M-Rollins/automated_chess_board/arduino_programming_info.txt

	As of 2025/08/16, works with:
Arduino IDE 1.8.16
Board: "Arduino Nano"
Processor: "ATmega328P (Old Bootloader)"
Programmer: "AVR ISP"

Driver (Ports>USB-Serial CH340): version 3.4.2014.8

2025/10/03: version 3.3.2011.11
https://sparks.gogo.co.nz/ch340.html
official site: https://www.wch-ic.com/downloads/ch341ser_zip.html
