M-Rollins/automated_chess_board/(list of files, cad)

Other CAD files:
hardware/rotary_switch_dimensions.SLDPRT
hardware/rotary_switch_dimensions.DXF
