M-Rollins/automated_chess_board/hardware/IO_board/IO_board.kicad_pcb

## KiCad design hardware/IO_board/IO_board.kicad_pcb (2025-12-19)

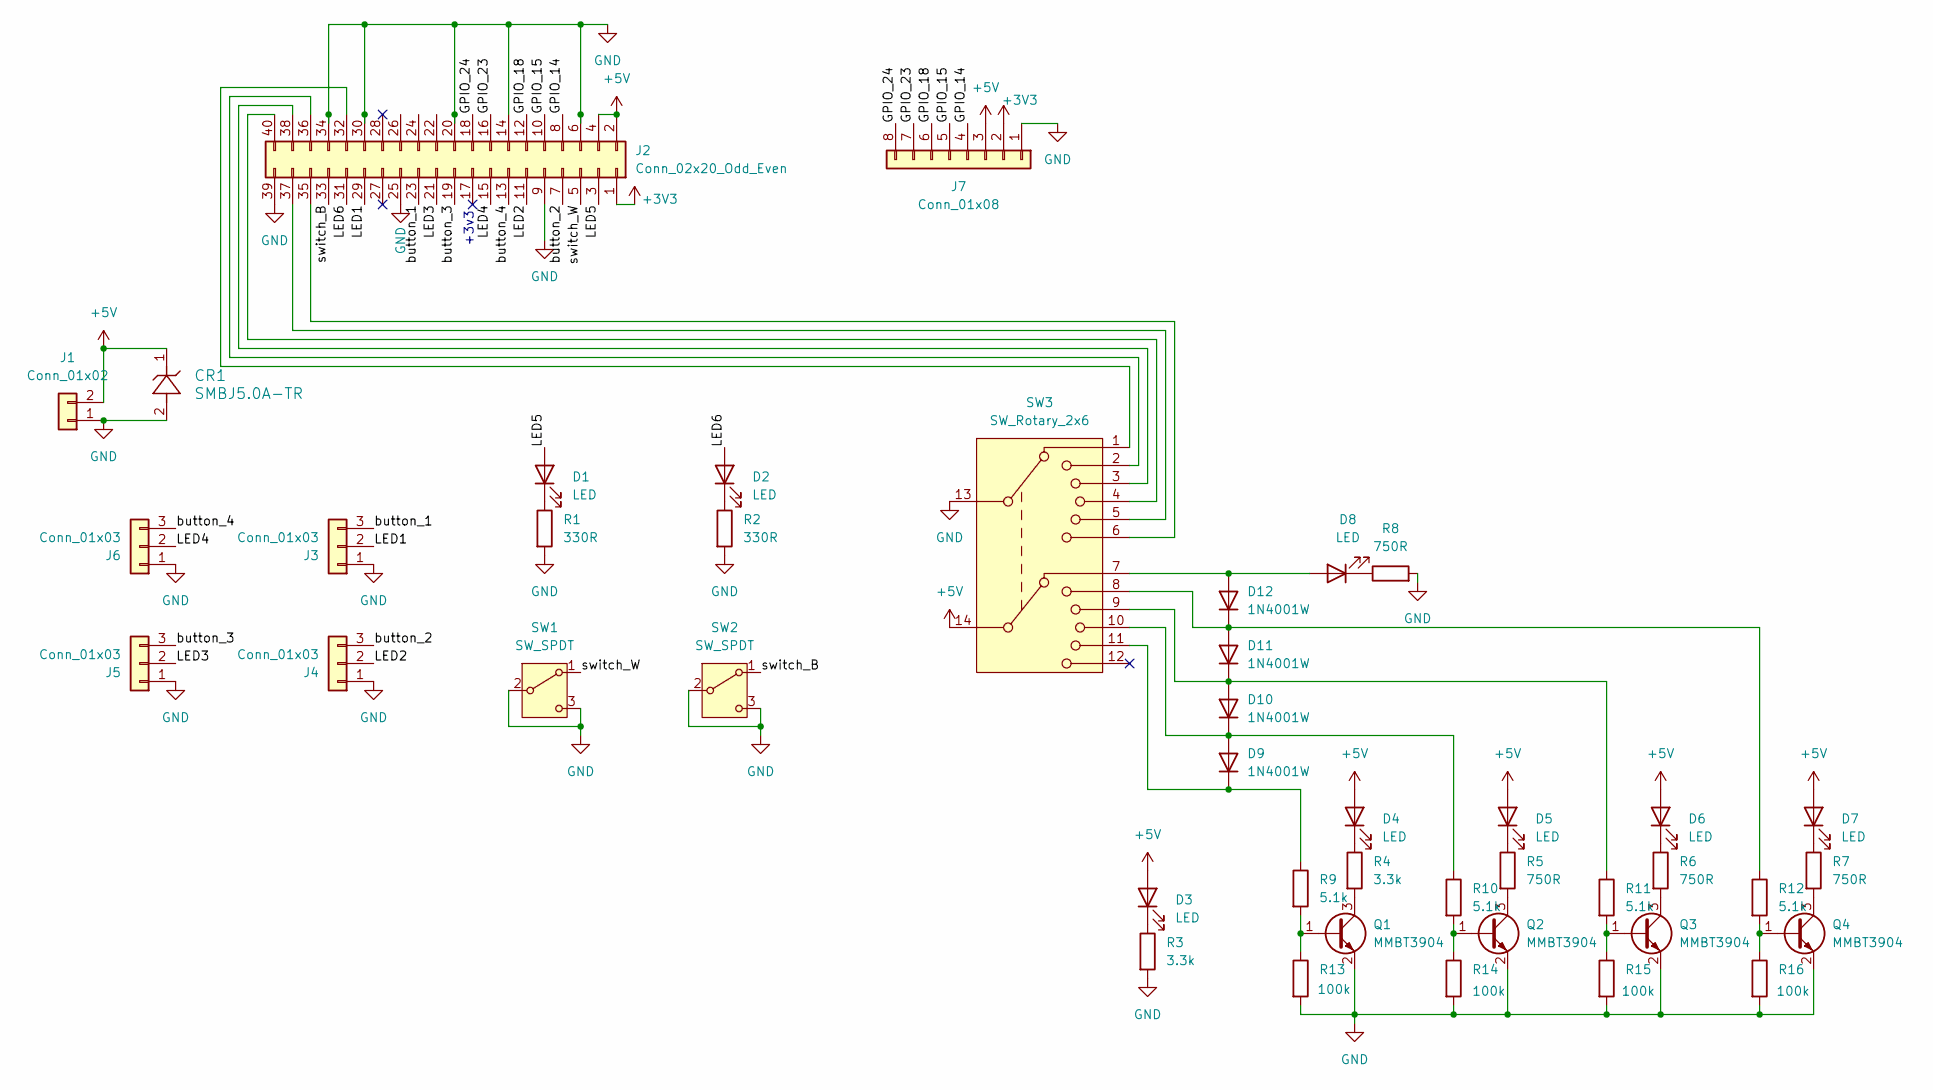
[picture p1: schematic IO_board.kicad_sch]

Parts:
CR1: SMBJ5.0A-TR; SMB_STM
D1, D2: LED; LED_D5.0mm
D3, D4, D5, D6, D7, D8: LED; LED_0805_2012Metric_Pad1.15x1.40mm_HandSolder
D9, D10, D11, D12: 1N4001W; D_SOD-123F
J1: Conn_01x02; JST_EH_B2B-EH-A_1x02_P2.50mm_Vertical
J2: Conn_02x20_Odd_Even; PinHeader_2x20_P2.54mm_Vertical_MIRROR
J3, J4, J5, J6: Conn_01x03; JST_EH_B3B-EH-A_1x03_P2.50mm_Vertical
J7: Conn_01x08; PinHeader_1x08_P2.54mm_Vertical
Q1, Q2, Q3, Q4: MMBT3904; SOT-23
R1, R2: 330R; R_0805_2012Metric_Pad1.20x1.40mm_HandSolder
R3, R4: 3.3k; R_0805_2012Metric_Pad1.20x1.40mm_HandSolder
R5, R6, R7, R8: 750R; R_0805_2012Metric_Pad1.20x1.40mm_HandSolder
R9, R10, R11, R12: 5.1k; R_0805_2012Metric_Pad1.20x1.40mm_HandSolder
R13, R14, R15, R16: 100k; R_0805_2012Metric_Pad1.20x1.40mm_HandSolder
SW1, SW2: SW_SPDT; SW_toggle
SW3: SW_Rotary_2x6; SW_rotary_2x6

Connections:
+3V3: J2.1, J7.2
+5V: CR1.1, D3.2 (A), D4.2 (A), D5.2 (A), D6.2 (A), D7.2 (A), J1.2, J2.2, J2.4, J7.3, SW3.14
/GPIO_14: J2.8, J7.4
/GPIO_15: J2.10, J7.5
/GPIO_18: J2.12, J7.6
/GPIO_23: J2.16, J7.7
/GPIO_24: J2.18, J7.8
/LED1: J2.29, J3.2
/LED2: J2.11, J4.2
/LED3: J2.21, J5.2
/LED4: J2.15, J6.2
/LED5: D1.2 (A), J2.3
/LED6: D2.2 (A), J2.31
/button_1: J2.23, J3.3
/button_2: J2.7, J4.3
/button_3: J2.19, J5.3
/button_4: J2.13, J6.3
/switch_B: J2.33, SW2.1 (A)
/switch_W: J2.5, SW1.1 (A)
GND: CR1.2, J1.1, J2.6, J2.9, J2.14, J2.20, J2.25, J2.30, J2.34, J2.39, J3.1, J4.1, J5.1, J6.1, J7.1, Q1.2 (E), Q2.2 (E), Q3.2 (E), Q4.2 (E), R1.2, R2.2, R3.2, R8.2, R13.2, R14.2, R15.2, R16.2, SW1.2 (B), SW1.3 (C), SW2.2 (B), SW2.3 (C), SW3.13
unnamed: D1.1 (K), R1.1
unnamed: D2.1 (K), R2.1
unnamed: D3.1 (K), R3.1
unnamed: D4.1 (K), R4.1
unnamed: D5.1 (K), R5.1
unnamed: D6.1 (K), R6.1
unnamed: D7.1 (K), R7.1
unnamed: D8.1 (K), R8.1
unnamed: D9.1 (K), R9.1, SW3.11
unnamed: D10.2 (A), D11.1 (K), R11.1, SW3.9
unnamed: D9.2 (A), D10.1 (K), R10.1, SW3.10
unnamed: D11.2 (A), D12.1 (K), R12.1, SW3.8
unnamed: D8.2 (A), D12.2 (A), SW3.7
unnamed: J2.32, SW3.1
unnamed: J2.35, SW3.6
unnamed: J2.36, SW3.2
unnamed: J2.37, SW3.5
unnamed: J2.38, SW3.3
unnamed: J2.40, SW3.4
unnamed: Q1.1 (B), R9.2, R13.1
unnamed: Q1.3 (C), R4.2
unnamed: Q2.1 (B), R10.2, R14.1
unnamed: Q2.3 (C), R5.2
unnamed: Q3.1 (B), R11.2, R15.1
unnamed: Q3.3 (C), R6.2
unnamed: Q4.1 (B), R12.2, R16.1
unnamed: Q4.3 (C), R7.2

Notes on the sheet:
+3v3

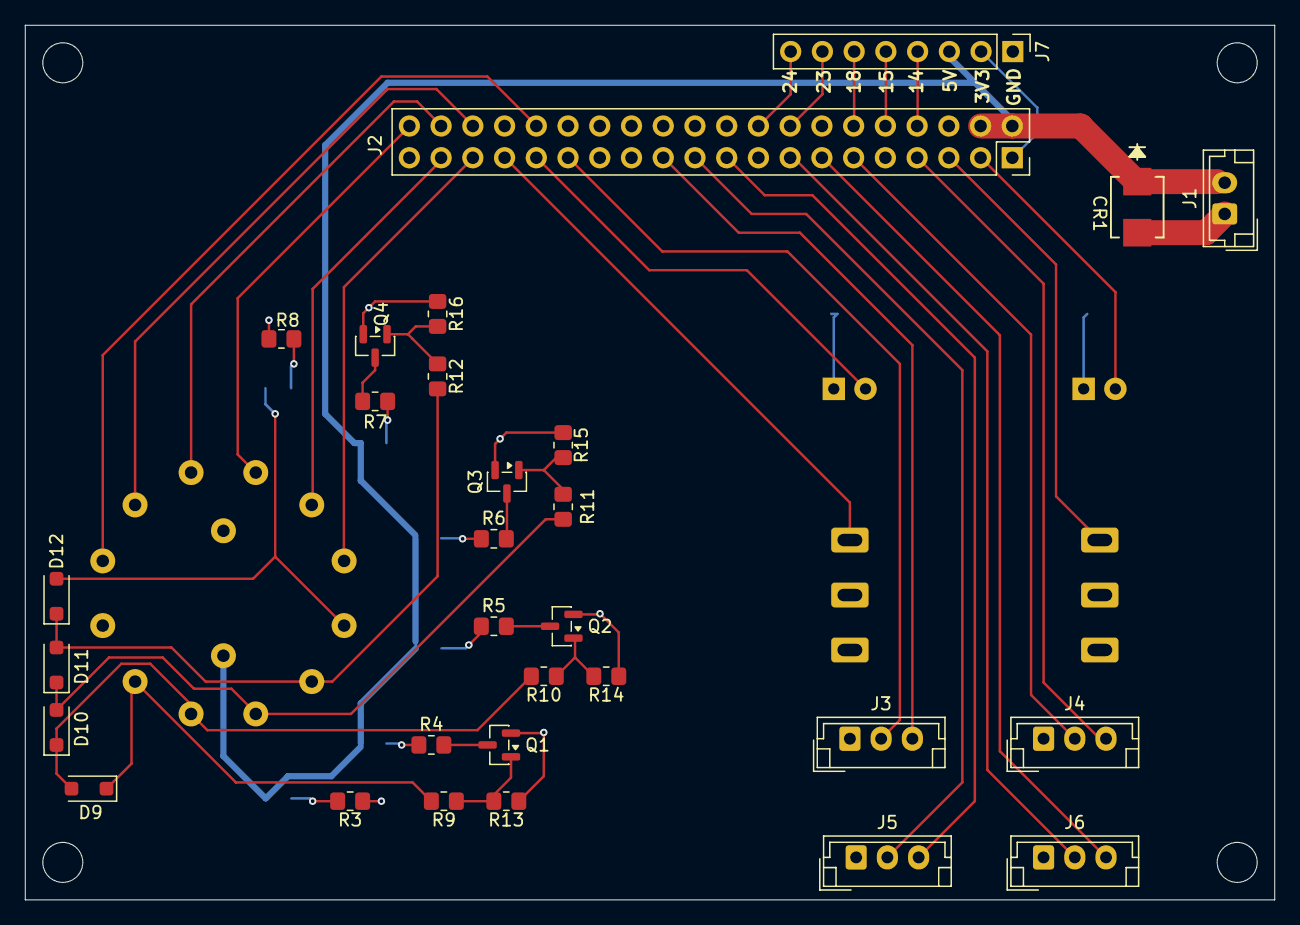
[picture p2: board IO_board.kicad_pcb from above]

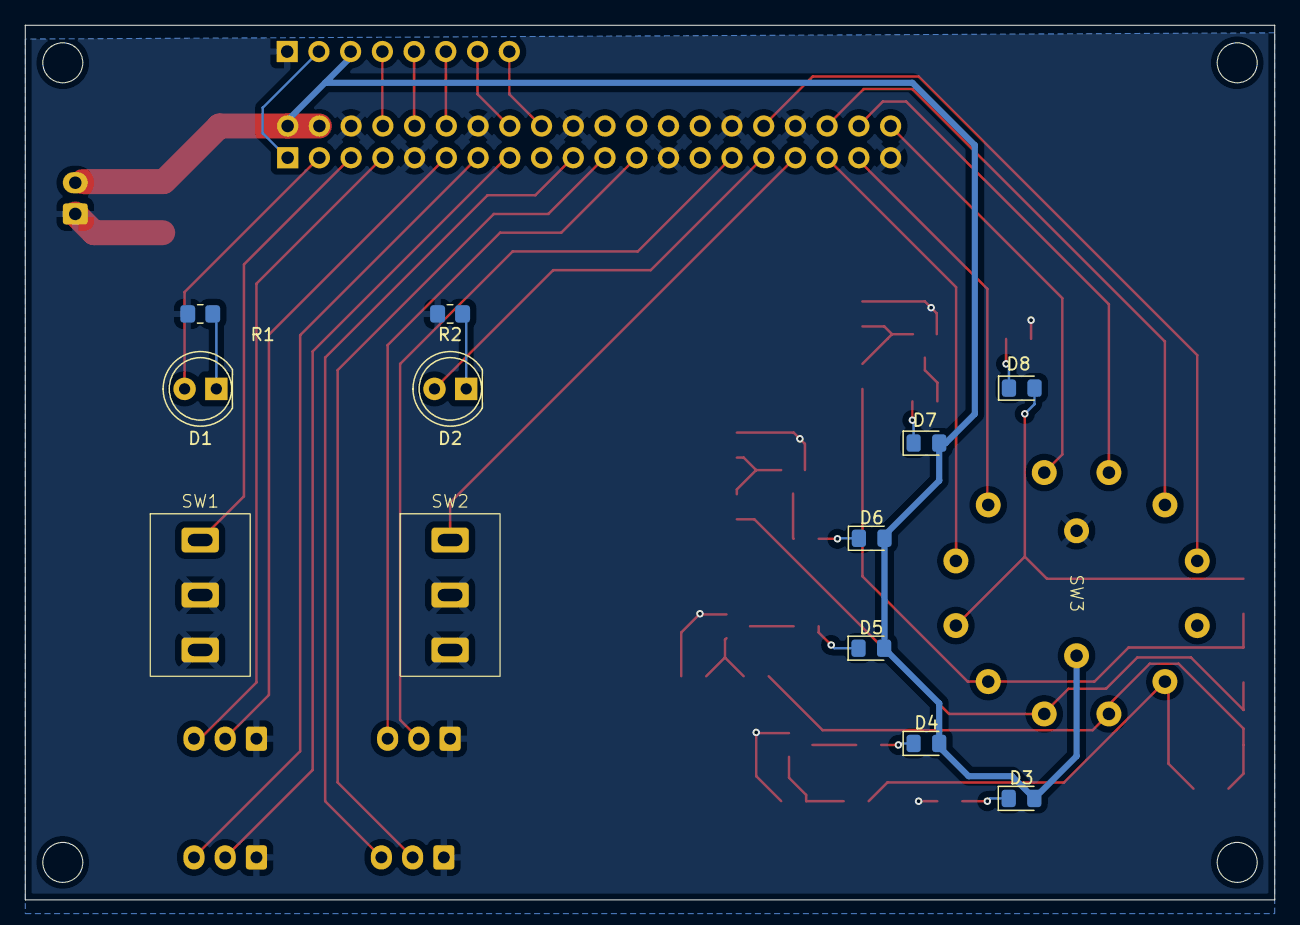
[picture p3: board IO_board.kicad_pcb from below]

Board: 2 copper layers, 100.0 x 70.0 mm, 43 parts (13 on the bottom side), 47 nets.
