M-Rollins/automated_chess_board/arduino/BoardControl/MotorControl.cpp

/*
 * motor_control.cpp - classes for cnc control of stepper-driven motion axes
 */
#include "Arduino.h"
#include "MotorControl.h"

const int StepperMotor::PULSE_WIDTH_MICROSECONDS = 5;
const float Axis::V_MIN = 50; // full steps per second (1 step = 0.2mm)
const float Axis::V_MAX = 600;
const float Axis::HOME_SPEED = 400;
const float Axis::ACCEL = 1000; //full steps/s^2

const int Axis::GO_TO_TARGET = 0;
const int Axis::RAMP_CYCLE = 1;
const int Axis::SPLINE = 2;

//=======================================================
StepperMotor::StepperMotor(){}
StepperMotor::StepperMotor(int s, int d, int msPin1, int msPin2, boolean f){
  stepPin = s;
  dirPin = d;
  ms1 = msPin1;
  ms2 = msPin2;
  pinMode(stepPin, OUTPUT);
  pinMode(dirPin, OUTPUT);
  pinMode(ms1, OUTPUT);
  pinMode(ms2, OUTPUT);
  setMicrostepping(1);
  
  forward = f;
  digitalWrite(stepPin, LOW);
  digitalWrite(dirPin, forward);
}

boolean StepperMotor::setMicrostepping(int steps){
  switch(steps){
    case 1:
      digitalWrite(ms1, LOW);
      digitalWrite(ms2, LOW);
      return true;
    case 2:
      digitalWrite(ms1, HIGH);
      digitalWrite(ms2, LOW);
      return true;
    case 4:
      digitalWrite(ms1, LOW);
      digitalWrite(ms2, HIGH);
      return true;
    case 8:
      digitalWrite(ms1, HIGH);
      digitalWrite(ms2, HIGH);
      return true;
    default:
      Serial.println("Invalid microstep resolution. Only values of 1, 2, 4, and 8 are valid.");
      return false;    
  }
}

void StepperMotor::step(boolean d){
  digitalWrite(dirPin, d == forward);
  digitalWrite(stepPin, HIGH);
  delayMicroseconds(PULSE_WIDTH_MICROSECONDS);
  digitalWrite(stepPin, LOW);
  delayMicroseconds(PULSE_WIDTH_MICROSECONDS);
}

//=======================================================
Axis::Axis(){}
Axis::Axis(StepperMotor m, int lp, int switchPin){
  motor = m;
  limitPos = lp;
  safetyLimit = limitPos + 1000;
  limSwitch = switchPin;
  pos = 0;
  target = 0;
  v = 0;
  speedFactor = 1;
  isHomed = false;
  mode = GO_TO_TARGET;
  pinMode(limSwitch, INPUT_PULLUP);
  setMicrostepping(1);
}

void Axis::setMicrostepping(int steps){
  if(motor.setMicrostepping(steps)){
    microstepping = steps;
  }else{
    Serial.println("error setting microstepping resolution");
  }
}

//pass a number between 0 and 1 to slow down the axis
void Axis::setSpeedFactor(float s){
  speedFactor = s;
}

void Axis::setTarget(int t){
  target = t;
  mode = GO_TO_TARGET;
}

void Axis::followRampCycle(float currentSpeed, float accel, float coastStartTime, float coastStopTime, float cycleStopTime){
  mode = RAMP_CYCLE;
  x0 = pos;
  v0 = currentSpeed;
  a0 = accel;
  lastTime = micros();
  t1 = coastStartTime;
  t2 = coastStopTime;
  tf = cycleStopTime;
}

void Axis::followSpline(float a, float b, float c, float stopTime){
  mode = SPLINE;
  x0 = pos;
  v0 = c;
  a0 = b;
  jerk = a;
  lastTime = micros();
  tf = stopTime;
}

boolean Axis::atTarget(){
  return mode == GO_TO_TARGET && pos == target;
}

int Axis::getPos(){
  return pos;
}

boolean Axis::homeAxis(){
  float lastTime = micros();
  stepDelay = 1000000 / (HOME_SPEED * microstepping);

  //move the axis until reaching the limit switch
  while(!digitalRead(limSwitch)){
    unsigned long t = micros();
    if(t - lastTime > stepDelay){
      //update the time, but avoid sending many steps in quick succession if there is a delay
      while(t - lastTime >= stepDelay) {lastTime += stepDelay;};
      motor.step(true);
      pos += 1./microstepping;

      //stop the program if the limit switch is not detected
      if(pos >= safetyLimit){
        isHomed = false;
        return false;
      }
    }
  }
  //recognize the home position
  pos = limitPos;
  target = pos;
  isHomed = true;
  return true;
}


void Axis::updateAxis(){
  //don't move without knowing where the axis is
  if(!isHomed){
    return;
  }

  switch(mode){
    case GO_TO_TARGET:
      updateGoToTarget();
      break;
    case RAMP_CYCLE:
      updateRampCycle();
      break;
    case SPLINE:
      updateSpline();
      break;
  }
}

void Axis::updateGoToTarget(){
  if(pos == target){
    return;
  }
  
  if(v == 0){
    // when the motor is stopped and gets a new target position, start moving
    v = V_MIN * speedFactor;
    rampUp = true;
    lastTime = micros();
    return;
  }
  
  //move the motor
  stepDelay = 1000000 / (v * microstepping);

  //TODO: overflow protection? (rolls over every ~1hr)
  unsigned long t = micros();
  if(t - lastTime >= stepDelay){
    //update the time, but avoid sending many steps in quick succession if there is a delay
    while(t - lastTime >= stepDelay) {lastTime += stepDelay;};
    if(pos < target){
      motor.step(true);
      pos += 1./microstepping;
    }else if (pos > target){
      motor.step(false);
      pos -= 1./microstepping;
    }
    //check the limit swicth after each step
    if(digitalRead(limSwitch)){
      pos = limitPos;
    }
    
    //accelerate up to max speed
    if(rampUp){
      v += ACCEL * speedFactor * stepDelay/1000000.;
      if(v >= V_MAX * speedFactor) {
        v = V_MAX * speedFactor;
        rampUp = false;
      }
    }
    // decelerate down to minimum speed as the destination approaches
    float stoppingDist = 1. / (2*ACCEL * speedFactor) * (v*v - V_MIN*V_MIN*speedFactor*speedFactor);
    if(abs(pos - target) <= stoppingDist){
      v = max(float(v - ACCEL * speedFactor * stepDelay/1000000.), V_MIN * speedFactor);
      rampUp = false;
    }
  }

  // stop moving when the target is reached
  if(pos == target){
    v = 0;
  }
}

void Axis::updateRampCycle(){
  float t = (micros() - lastTime) / 1000000.;
  float x;
  if(t <= t1){
    x = x0 + v0*t + 0.5*a0*t*t;
  }else if(t <= t2){
    x = x0 + (v0*t1 + 0.5*a0*t1*t1) + (v0 + t1*a0) * (t - t1);
  }else if(t <= tf){
    x = x0 + (v0*t1 + 0.5*a0*t1*t1) + (v0 + t1*a0) * (t - t1) +  - 0.5*a0*(t - t2)*(t - t2);
  }else{
    //end of cycle
    mode = GO_TO_TARGET;
    target = pos;
    return;
  }

  if(x - pos > 0.5/microstepping){
    motor.step(true);
    pos += 1./microstepping;
  }else if(x - pos < -0.5/microstepping){
    motor.step(false);
    pos -= 1./microstepping;
  }
}

void Axis::updateSpline(){
  float t = (micros() - lastTime) / 1000000.;
  if(t <= tf){
    float x = jerk*t*t*t + a0*t*t + v0*t + x0;
    if(x - pos > 0.5/microstepping){
      motor.step(true);
      pos += 1./microstepping;
    }else if(x - pos < -0.5/microstepping){
      motor.step(false);
      pos -= 1./microstepping;
    }
  }else{
    //end of cycle
    mode = GO_TO_TARGET;
    target = pos;
    return;
  }
}
