M-Rollins/automated_chess_board/(commit log)

2025-01-19 adjustded board dimensions
2025-06-28 added reference for board commands
2025-06-29 Broke motion control into separate library
    MotorControl library contains StepperMotor class plus new Axis class which stores current and target position for one motor and controls motion
    [BoardControl.ino, MotorControl.cpp, MotorControl.h]
2025-08-18 command handling and board tracking updates
    - Modified command parsing
    - began implementing board state tracking and board-aware path planning for piece movement
2025-08-20 Implemented board-aware movement (no captures) (untested)
    - Instead of moving pieces directly from starting to ending squares, the program tracks the board state and attempts to find the shortest path that does not cross any occupied squares.
    - Added a command to print out the board state
    * captures are not yet implemented. Attempting a move where the destination square is occupied will result in failure to find a valid path.
    * Code compiles, but changed have not been tested on the board
    [BoardControl.ino]
2025-10-04 Saved drivers that work with arduino
2025-10-04 reversed order of ranks in board representation
    [BoardControl.ino]
2025-10-05 Added command to play moves using algebraic notation
    -some bugs with path finding / capture logic (ranks and files flipped somewhere?)
    [BoardControl.ino]
2025-10-19 Path finding updates
    -Fixed path finding logic errors
    -Added function to realign pieces
    -Minor refactoring
    -Notes:
    -close to memory limit, may cause issues
    -serial input buffer is 64 bytes: transmitting longer strings at a time causes problems
    [BoardControl.ino, MotorControl.cpp]
2025-10-19 Implemented board setup command and board dimension query, used F() wrapper for string literals to save dynamic memory
2025-11-16 Create engine_test.py
    Script for testing pychess SimpleEngine
    Note: the engine does not work in Spyder's IPython console (some kind of asyncio conflict). Needs to be run in an external terminal
    [engine_test.py]
2025-11-16 Began integrating physical board control with python script
    Upon running main.py, the computer connects to the microcontroller (running BoardControl.ino). The user can start a game with both, one, or neither side controlled by stockfish. During the game, moves are relayed to the microcontroller and played on the board.
2025-11-16 added functionality to computer-side code
    -added handling of castling
    -added commands to initalize/setup board, home axes, adjust pieces
    -added ability to quit and then resume a game
2025-11-19 Updated pathing
    Path finding updates:
    -Use Djikstra's algorithm to find shortest path
    -Include knight's moves (e.g. (+1, +2))
    -Penalty for changing direction
    -Penalty for making diagonal moves next to pieces
    -When x and y need to move different distances, scale speeds so they move in a straight line and arrive at the same time
    [BoardControl.ino, MotorControl.cpp, MotorControl.h, PathFollowing.ino]
2025-11-30 Implemented smooth path following
    Instead of stopping at each direction change, the tool takes a path that passes through the points with smooth velocities.
2025-12-19 Uploaded IO PCB design files
    [IO_board-B_Cu.gbr, IO_board-B_Mask.gbr, IO_board-B_Paste.gbr, IO_board-B_Silkscreen.gbr, IO_board-Edge_Cuts.gbr, IO_board-F_Cu.gbr, IO_board-F_Mask.gbr, IO_board-F_Paste.gbr]
2026-04-11 Frist attempt at using IO board for control
    [IO_board.csv]
2026-05-03 Soft LED blinking
